besi/guitar-amp/preamp/preamp.kicad_pcb

## KiCad design preamp/preamp.kicad_pcb (2023-05-06)

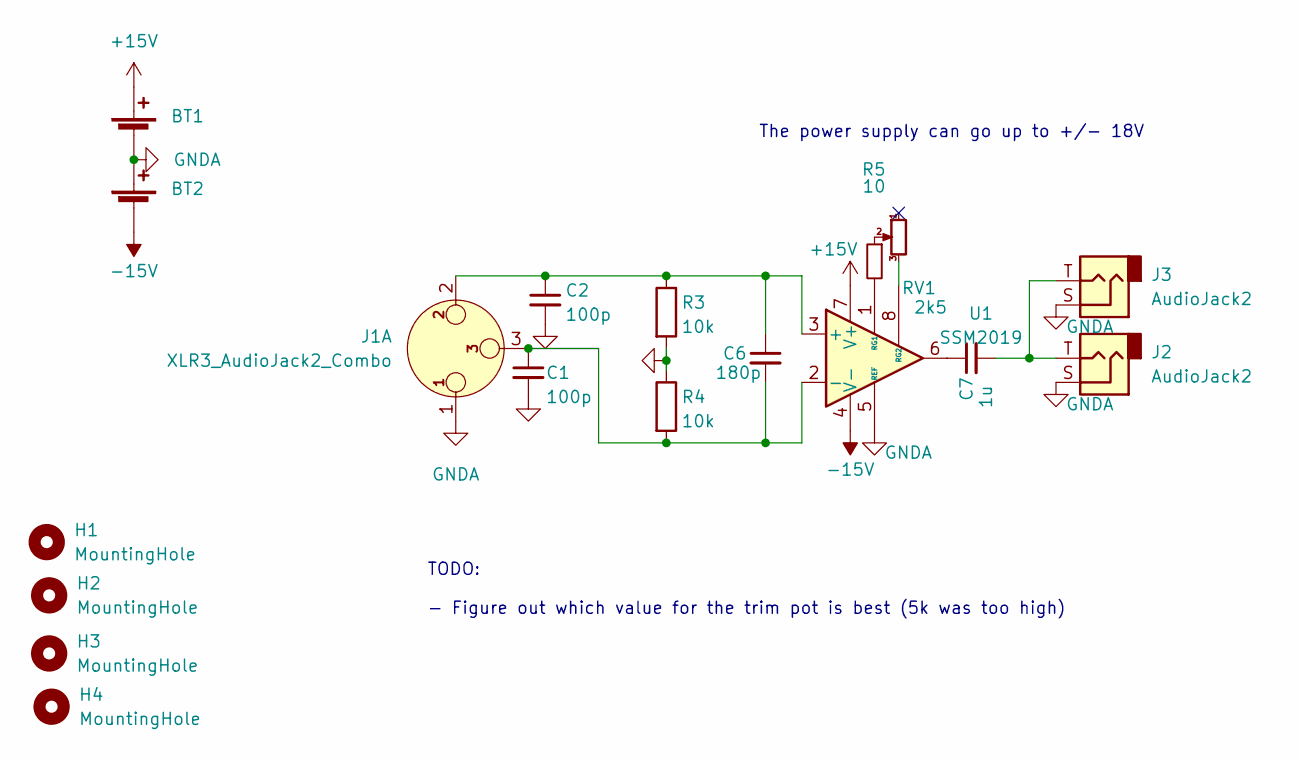
[picture p2: schematic preamp.kicad_sch, XLR Preamp]

Parts:
BT1, BT2: Battery_Cell; BarrelJack_GCT_DCJ200-10-A_Horizontal
C1, C2: 100p; C_Disc_D3.0mm_W1.6mm_P2.50mm
C6: 180p; C_Disc_D3.0mm_W1.6mm_P2.50mm
C7: 1u; C_Rect_L7.0mm_W2.5mm_P5.00mm
H1, H2, H3, H4: MountingHole; MountingHole_3.2mm_M3_DIN965
J1: XLR3_AudioJack2_Combo; Jack_XLR_Neutrik_NC3FAAH2_Horizontal
J2: AudioJack2; Jack_6.35mm_Neutrik_NMJ6HFD2_Horizontal
J3: AudioJack2; Jack_3.5mm_CUI_SJ-3523-SMT_Horizontal
R3, R4: 10k; R_Axial_DIN0207_L6.3mm_D2.5mm_P7.62mm_Horizontal
R5: 10; R_Axial_DIN0207_L6.3mm_D2.5mm_P7.62mm_Horizontal
RV1: 2k5; Potentiometer_Alps_RK163_Single_Horizontal
U1: SSM2019; DIP-8_W7.62mm_LongPads

Connections:
+15V: BT1.1 (+), U1.7 (V+)
-15V: BT2.2 (-), U1.4 (V-)
GNDA: BT1.2 (-), BT2.1 (+), C1.2, C2.2, J1.1, J2.S, J3.S, R3.2, R4.1, U1.5 (REF)
unnamed: C1.1, C6.2, J1.3, R4.2, U1.2 (-)
unnamed: C2.1, C6.1, J1.2, R3.1, U1.3 (+)
unnamed: C7.1, U1.6
unnamed: C7.2, J2.T, J3.T
unnamed: R5.1, RV1.2
unnamed: R5.2, U1.1 (RG1)
unnamed: RV1.3, U1.8 (RG2)

Notes on the sheet:
The power supply can go up to +/- 18V
TODO: - Figure out which value for the trim pot is best (5k was too high)

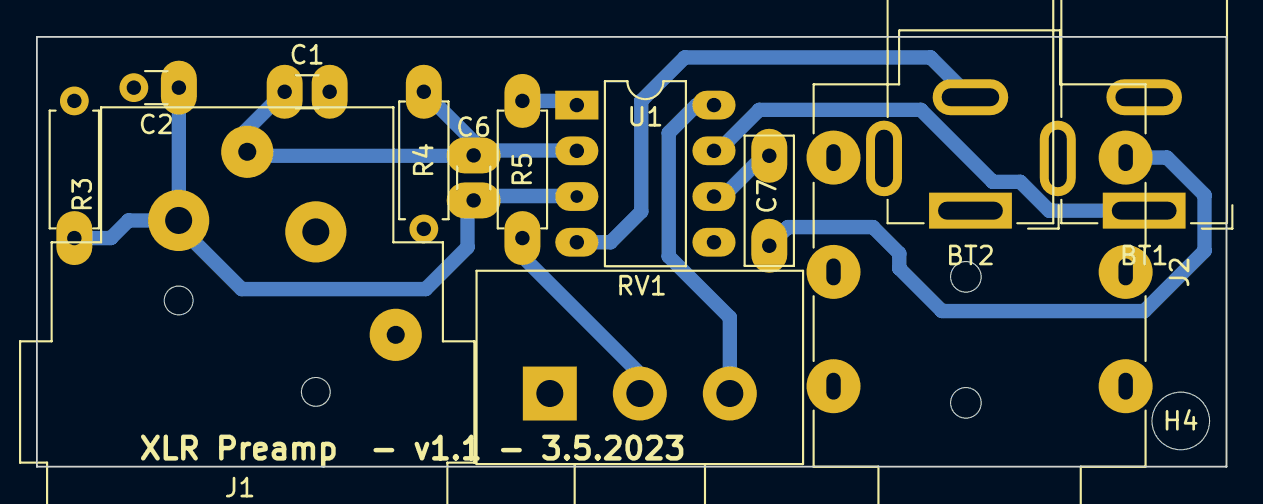
[picture p3: board preamp.kicad_pcb from above]

Board: 2 copper layers, 66.1 x 23.9 mm, 18 parts (1 on the bottom side), 10 nets.
