besi/guitar-amp/guitar-amp.kicad_pcb

## KiCad design guitar-amp.kicad_pcb (2023-04-24)

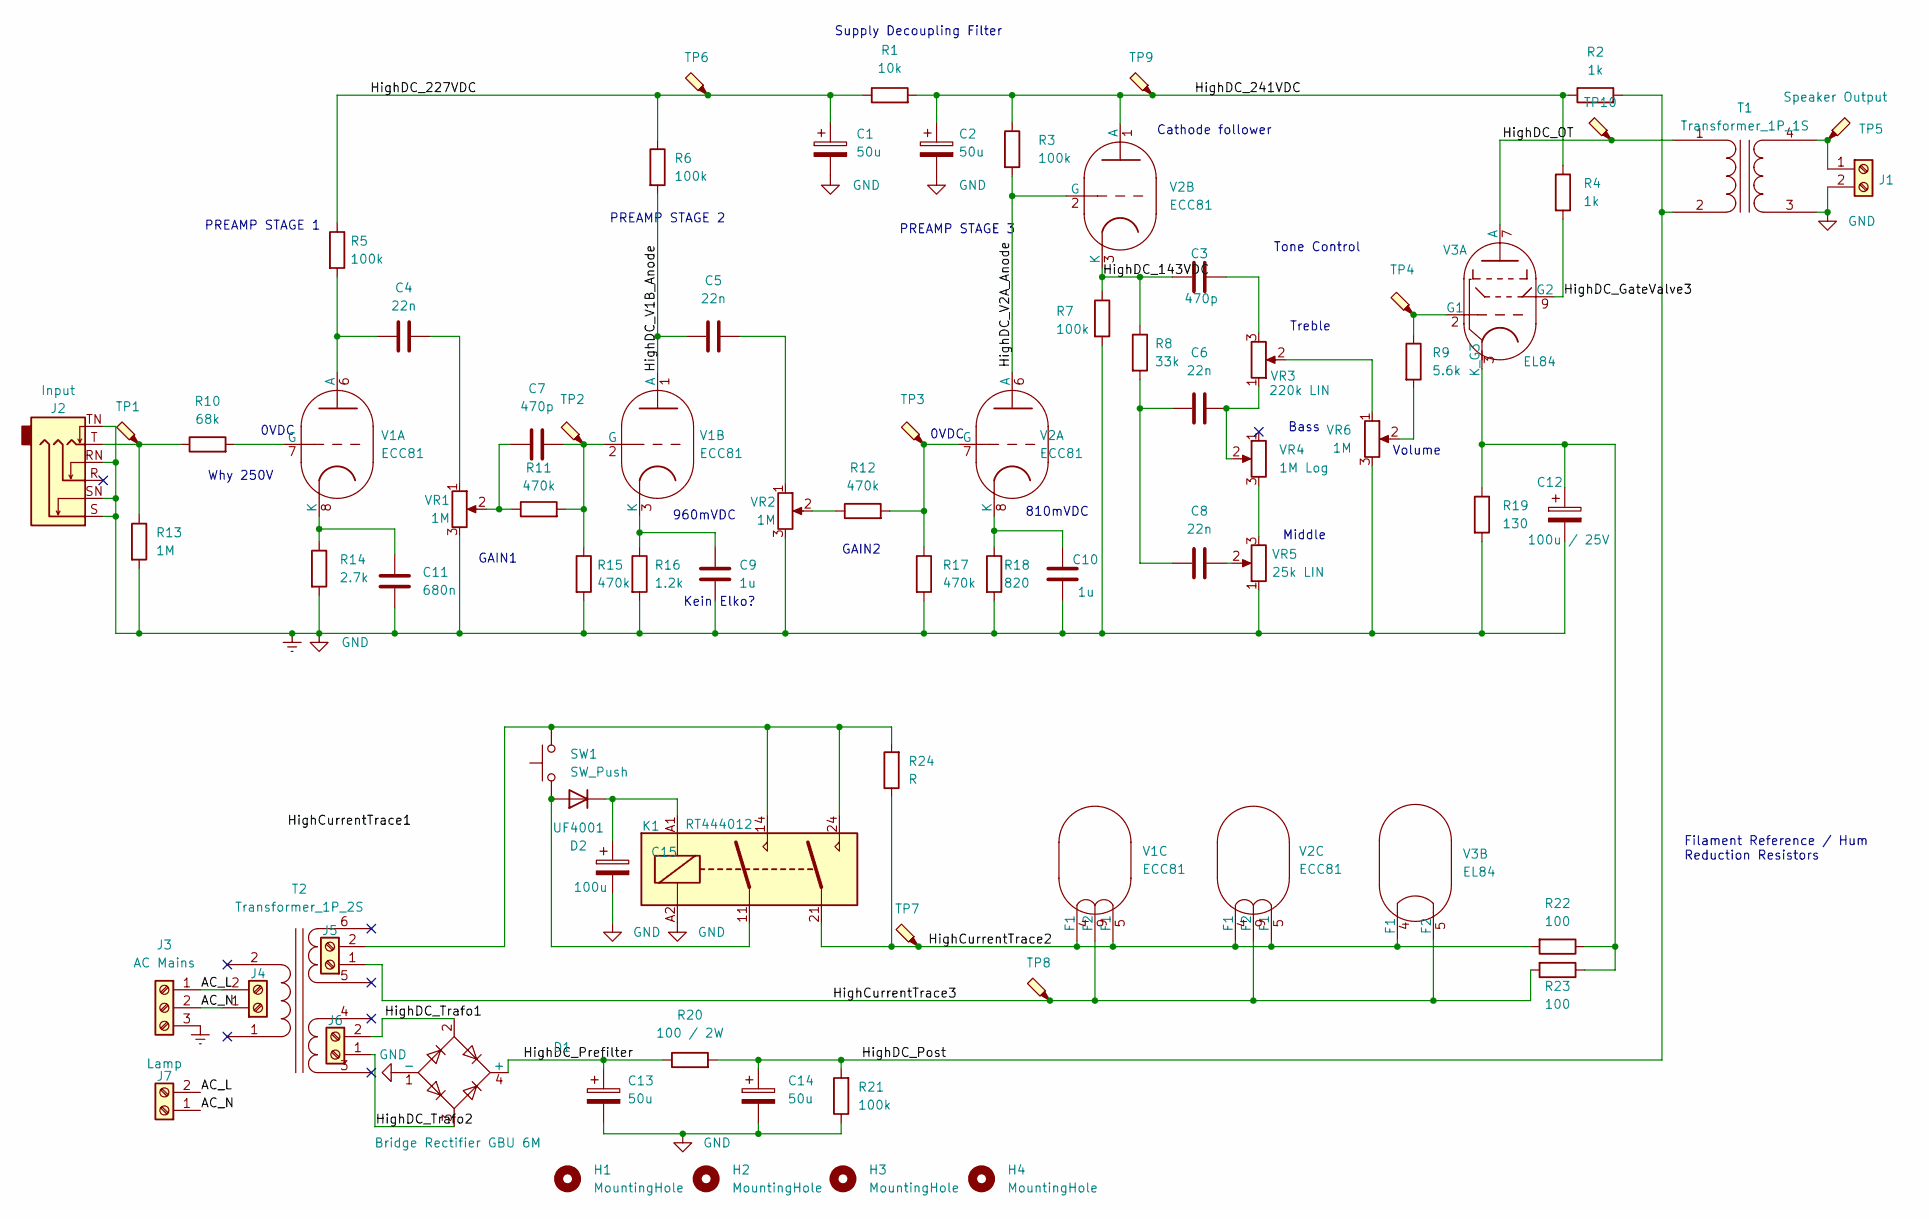
[picture p4: schematic guitar-amp.kicad_sch, Guitar Amp based on High Octane]

Parts:
C1, C2, C13, C14: 50u; CP_Radial_D16.0mm_P7.50mm
C3, C7: 470p; C_Disc_D7.0mm_W2.5mm_P5.00mm
C4, C5, C6, C8: 22n; C_Rect_L18.0mm_W5.0mm_P15.00mm_FKS3_FKP3
C9, C10: 1u; C_Rect_L10.3mm_W5.0mm_P7.50mm_MKS4
C11: 680n; C_Axial_L17.0mm_D7.0mm_P20.00mm_Horizontal
C12: 100u / 25V; CP_Radial_D8.0mm_P3.80mm
C15: 100u
D1: Bridge Rectifier GBU 6M; Diode_Bridge_Vishay_GBU
D2: UF4001; D_DO-41_SOD81_P10.16mm_Horizontal
H1, H2, H3, H4: MountingHole; MountingHole_3.2mm_M3
J1: Speaker Output; TerminalBlock_RND_205-00001_1x02_P5.00mm_Horizontal
J2: Input; Jack_6.35mm_Neutrik_NMJ6HFD2-AU_Horizontal
J3: AC Mains; TerminalBlock_RND_205-00002_1x03_P5.00mm_Horizontal
J4, J5, J6: Screw_Terminal_01x02; TerminalBlock_RND_205-00001_1x02_P5.00mm_Horizontal
J7: Lamp; TerminalBlock_RND_205-00001_1x02_P5.00mm_Horizontal
K1: RT444012; Relay_DPST_Schrack-RT2-FormA_RM5mm
R1: 10k; R_Axial_DIN0411_L9.9mm_D3.6mm_P12.70mm_Horizontal
R2, R4: 1k; R_Axial_DIN0411_L9.9mm_D3.6mm_P12.70mm_Horizontal
R3, R5, R6, R7: 100k; R_Axial_DIN0207_L6.3mm_D2.5mm_P7.62mm_Horizontal
R8: 33k; R_Axial_DIN0207_L6.3mm_D2.5mm_P7.62mm_Horizontal
R9: 5.6k; R_Axial_DIN0207_L6.3mm_D2.5mm_P7.62mm_Horizontal
R10: 68k; R_Axial_DIN0207_L6.3mm_D2.5mm_P7.62mm_Horizontal
R11, R12, R15, R17: 470k; R_Axial_DIN0207_L6.3mm_D2.5mm_P7.62mm_Horizontal
R13: 1M; R_Axial_DIN0207_L6.3mm_D2.5mm_P7.62mm_Horizontal
R14: 2.7k; R_Axial_DIN0207_L6.3mm_D2.5mm_P7.62mm_Horizontal
R16: 1.2k; R_Axial_DIN0207_L6.3mm_D2.5mm_P7.62mm_Horizontal
R18: 820; R_Axial_DIN0207_L6.3mm_D2.5mm_P7.62mm_Horizontal
R19: 130; R_Axial_DIN0411_L9.9mm_D3.6mm_P12.70mm_Horizontal
R20: 100 / 2W; R_Axial_DIN0411_L9.9mm_D3.6mm_P12.70mm_Horizontal
R21: 100k; R_Axial_DIN0411_L9.9mm_D3.6mm_P12.70mm_Horizontal
R22, R23: 100; R_Axial_DIN0207_L6.3mm_D2.5mm_P7.62mm_Horizontal
R24: R; R_Axial_Power_L20.0mm_W6.4mm_P25.40mm
SW1: SW_Push; SW_Tactile_SPST_Angled_PTS645Vx58-2LFS
T1: Transformer_1P_1S; TerminalBlock_RND_205-00003_1x04_P5.00mm_Horizontal
T2: Transformer_1P_2S
TP1, TP2, TP3, TP4, TP5, TP6, TP7, TP8, TP9, TP10: TestPoint_Probe; TestPoint_Pad_D2.5mm
V1, V2: ECC81; Valve_ECC-83-1
V3: EL84; Valve_ECC-83-1
VR1, VR2, VR6: 1M; Potentiometer_Alps_RK163_Single_Horizontal
VR3: 220k LIN; Potentiometer_Alps_RK163_Single_Horizontal
VR4: 1M Log; Potentiometer_Alps_RK163_Single_Horizontal
VR5: 25k LIN; Potentiometer_Alps_RK163_Single_Horizontal

Connections:
/AC_L: J3.1, J4.2, J7.2
/AC_N: J3.2, J4.1, J7.1
/HighCurrentTrace2: K1.21, R22.2, R24.1, TP7.1, V1.4 (F1), V1.5 (F1), V2.4 (F1), V2.5 (F1), V3.4 (F1)
/HighCurrentTrace3: J5.1, R23.2, TP8.1, V1.9 (F2), V2.9 (F2), V3.5 (F2)
/HighDC_143VDC: C3.1, R7.1, R8.1, V2.3 (K)
/HighDC_227VDC: C1.1, R1.1, R5.1, R6.1, TP6.1
/HighDC_241VDC: C2.1, R1.2, R2.1, R3.1, R4.1, TP9.1, V2.1 (A)
/HighDC_GateValve3: R4.2, V3.9 (G2)
/HighDC_OT: T1.1 (AA), TP10.1, V3.7 (A)
/HighDC_Post: C14.1, R2.2, R20.2, R21.2, T1.2 (AB)
/HighDC_Prefilter: C13.1, D1.4 (+), R20.1
/HighDC_Trafo1: D1.2, J6.2
/HighDC_Trafo2: D1.3, J6.1
/HighDC_V1B_Anode: C5.1, R6.2, V1.1 (A)
/HighDC_V2A_Anode: R3.2, V2.2 (G), V2.6 (A)
Earth: C1.2, C2.2, C9.2, C10.2, C11.2, C12.2, C13.2, C14.2, C15.2, D1.1 (-), J1.2, J2.RN, J2.S, J2.SN, J2.TN, J3.3, K1.A2, R7.2, R13.2, R14.2, R15.2, R16.2, R17.2, R18.2, R19.2, R21.1, T1.3 (SA), VR1.3, VR2.3, VR5.1, VR6.3
unnamed: C3.2, VR3.3
unnamed: C4.1, R5.2, V1.6 (A)
unnamed: C4.2, VR1.1
unnamed: C5.2, VR2.1
unnamed: C6.1, C8.1, R8.2
unnamed: C6.2, VR3.1, VR4.2
unnamed: C7.1, R11.1, VR1.2
unnamed: C7.2, R11.2, R15.1, TP2.1, V1.2 (G)
unnamed: C8.2, VR5.2
unnamed: C9.1, R16.1, V1.3 (K)
unnamed: C10.1, R18.1, V2.8 (K)
unnamed: C11.1, R14.1, V1.8 (K)
unnamed: C12.1, R19.1, R22.1, R23.1, V3.3 (K_G3)
unnamed: J1.1, T1.4 (SB), TP5.1
unnamed: J2.T, R10.1, R13.1, TP1.1
unnamed: J5.2, K1.14, K1.24, R24.2, SW1.2
unnamed: D2.2 (A), K1.11, SW1.1
unnamed: C15.1, D2.1 (K), K1.A1
unnamed: R9.1, TP4.1, V3.2 (G1)
unnamed: R9.2, VR6.2
unnamed: R10.2, V1.7 (G)
unnamed: R12.1, VR2.2
unnamed: R12.2, R17.1, TP3.1, V2.7 (G)
unnamed: VR3.2, VR6.1
unnamed: VR4.3, VR5.3

Notes on the sheet:
960mVDC
Cathode follower
Why 250V
PREAMP STAGE 1
Volume
Treble
Filament Reference / Hum Reduction Resistors
0VDC
810mVDC
Kein Elko?
GAIN1
GAIN2
PREAMP STAGE 3
PREAMP STAGE 2
Middle
Supply Decoupling Filter
Bass
Tone Control

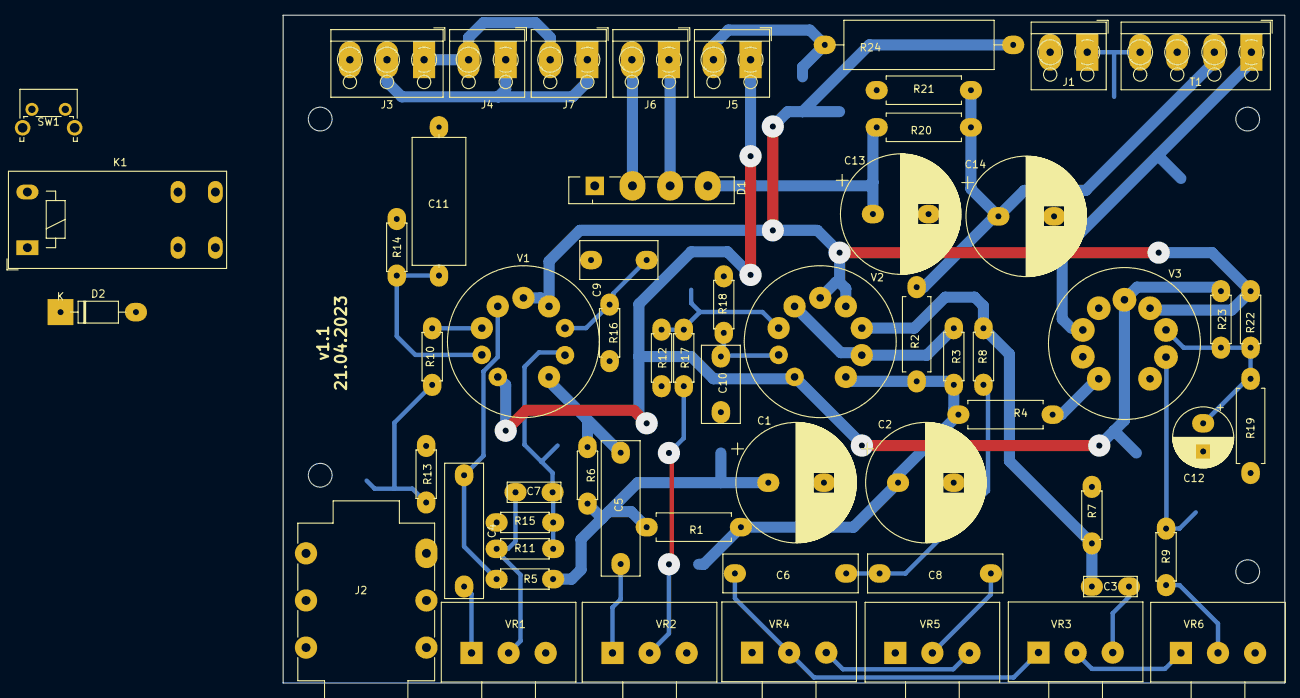
[picture p5: board guitar-amp.kicad_pcb from above]

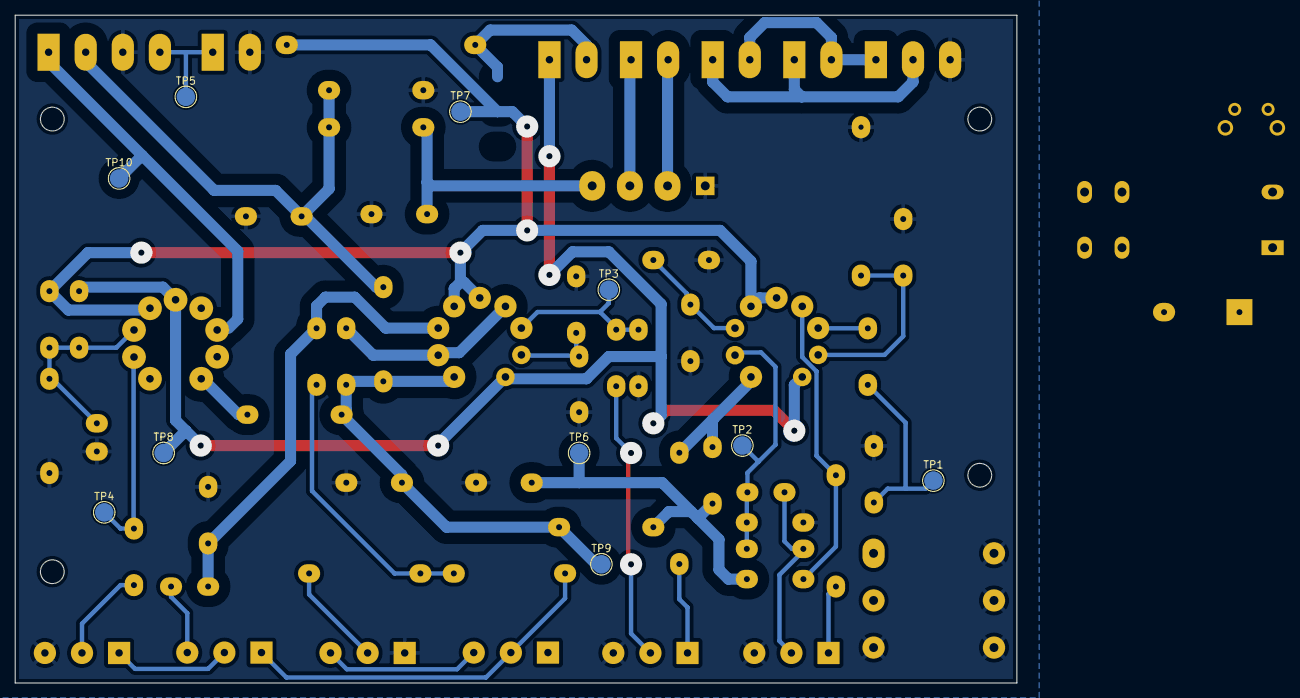
[picture p6: board guitar-amp.kicad_pcb from below]

Board: 2 copper layers, 135.0 x 90.0 mm, 73 parts (10 on the bottom side), 41 nets.
