besi/guitar-amp/(commit log)

2023-02-19 Added empty project
    [guitar-amp.kicad_pcb, guitar-amp.kicad_sch]
2023-03-10 Add valves
    [guitar-amp.kicad_pcb, guitar-amp.kicad_sch]
2023-04-04 Add resistors
    [guitar-amp.kicad_pcb, guitar-amp.kicad_sch]
2023-04-04 Add capacitors
    [guitar-amp.kicad_pcb, guitar-amp.kicad_sch]
2023-04-04 Add potentiometers
    [guitar-amp.kicad_pcb, guitar-amp.kicad_sch]
2023-04-11 Add guitar jack
    [guitar-amp.kicad_pcb, guitar-amp.kicad_sch]
2023-04-11 Model the schematic
    [guitar-amp.kicad_pcb, guitar-amp.kicad_sch]
2023-04-12 Roughly layout the components on the PCB
    [guitar-amp.kicad_pcb, guitar-amp.kicad_sch]
2023-04-12 First draft of routing
    [guitar-amp.kicad_pcb, guitar-amp.kicad_sch]
2023-04-16 Routing improvements
    [guitar-amp.kicad_pcb, guitar-amp.kicad_sch]
2023-04-16 update pads
    [guitar-amp.kicad_pcb]
2023-04-16 Update version
    [guitar-amp.kicad_sch]
2023-04-16 prepare for plotting
    [guitar-amp.kicad_pcb]
2023-04-21 Add lamp and test points
    [guitar-amp.kicad_pcb, guitar-amp.kicad_sch]
2023-04-21 Make the filament traces bigger
    [guitar-amp.kicad_pcb, guitar-amp.kicad_sch]
2023-04-21 Integrate feedback from stackoverflow
    [guitar-amp.kicad_pcb]
2023-04-24 Fix R6 and Remove C15
    [guitar-amp.kicad_pcb, guitar-amp.kicad_sch]
2023-04-24 Self latching circuit for soft start
    [guitar-amp.kicad_pcb, guitar-amp.kicad_sch]
2023-04-29 Add preamp for mic
    [preamp.kicad_pcb, preamp.kicad_sch]
2023-04-29 Prepare for routing
    [preamp.kicad_pcb, preamp.kicad_sch]
2023-04-30 Add RCA Plug
    [preamp.kicad_pcb, preamp.kicad_sch]
2023-04-30 Routing of preamp
    [preamp.kicad_pcb, preamp.kicad_sch]
2023-04-30 Add 3d models
    [preamp.kicad_pcb]
2023-05-01 Add mounting holes
    [preamp.kicad_pcb, preamp.kicad_sch]
2023-05-01 Prepare for milling
    [preamp.kicad_pcb, preamp.kicad_sch]
2023-05-02 Update board with the findings of the pcb
    [preamp.kicad_pcb, preamp.kicad_sch]
2023-05-05 Replace the RCA jack with an Audio Jack
    [preamp.kicad_pcb, preamp.kicad_sch]
2023-05-06 Small improvements
    [preamp.kicad_pcb]
2023-05-06 Small changes
    [preamp.kicad_pcb]
